ArjunRamphal/garden-iot-watering-guidance/(commit log)

2026-11-11 Add Raspberry Pi application and setup scripts
2026-11-11 Add Arduino soil moisture sensor sketch
2026-11-11 Add prototype and dashboard images
